Acmex2564/Z31-HVAC/README.md

# Z31-HVAC

This sure is a thing

36 pin board connector is TE 172023-1 Dual-Line Interlock (DLI). Same connector as on ECU. Same connector series as TCU, ASCD, Suspension Controller, DD Power Supply. 

5 pin board connector is TE 172040-1 - Multi Interlock Connector (MIC) Mk II.
