Acmex2564/Z31-HVAC/(threads)

Thread 1 (2022-05-30):

Wrong voltage divider values for discrete signals

Acmex2564, 2022-05-30:
150k/35.7k voltage divider inadequate to get logical high value from battery voltage (12V-12.7V). Reduce top of divider to ~100k (80k achieves reliable operation down to 8.7V)

Thread 2 (2022-05-30):

Silkscreen pinout on bottom of board

Acmex2564, 2022-05-30:
Currently half of the pin names are obscured by the connector when installed. All values should be replicated on the opposite board face.
