Acmex2564/Z31-HVAC/Design/Z31_HVAC_Disp_Rev2/Z31_HVAC_Disp_Rev2.kicad_pcb

## KiCad design Design/Z31_HVAC_Disp_Rev2/Z31_HVAC_Disp_Rev2.kicad_pcb (2022-09-29)

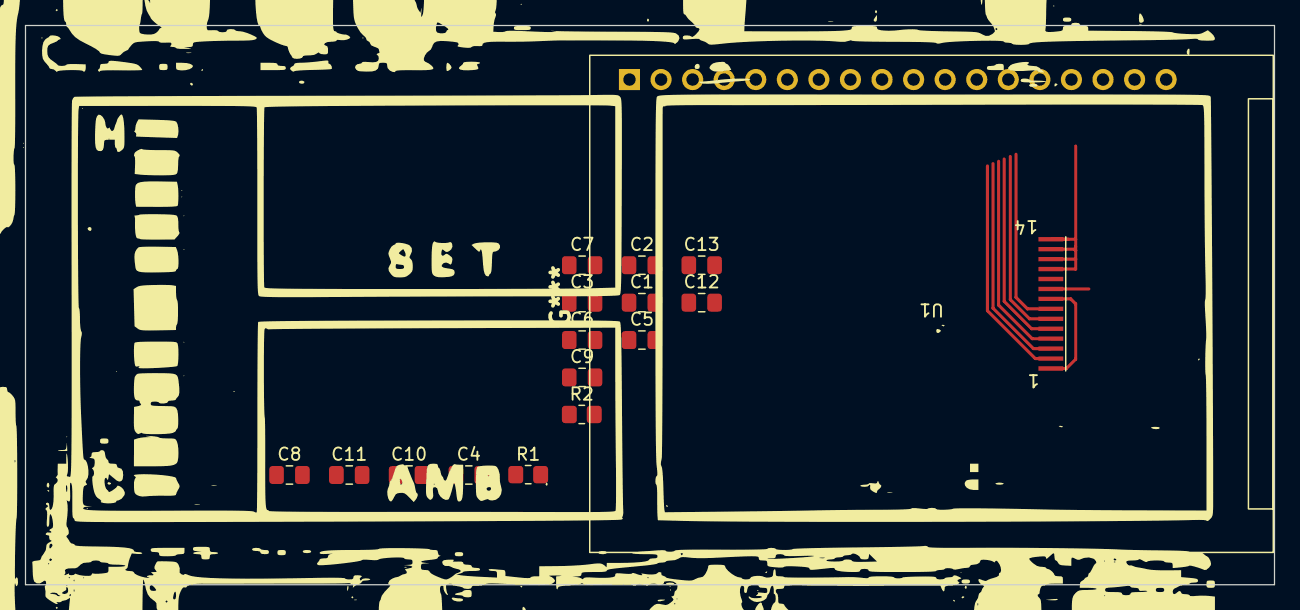
[picture p1: board Z31_HVAC_Disp_Rev2.kicad_pcb from above]

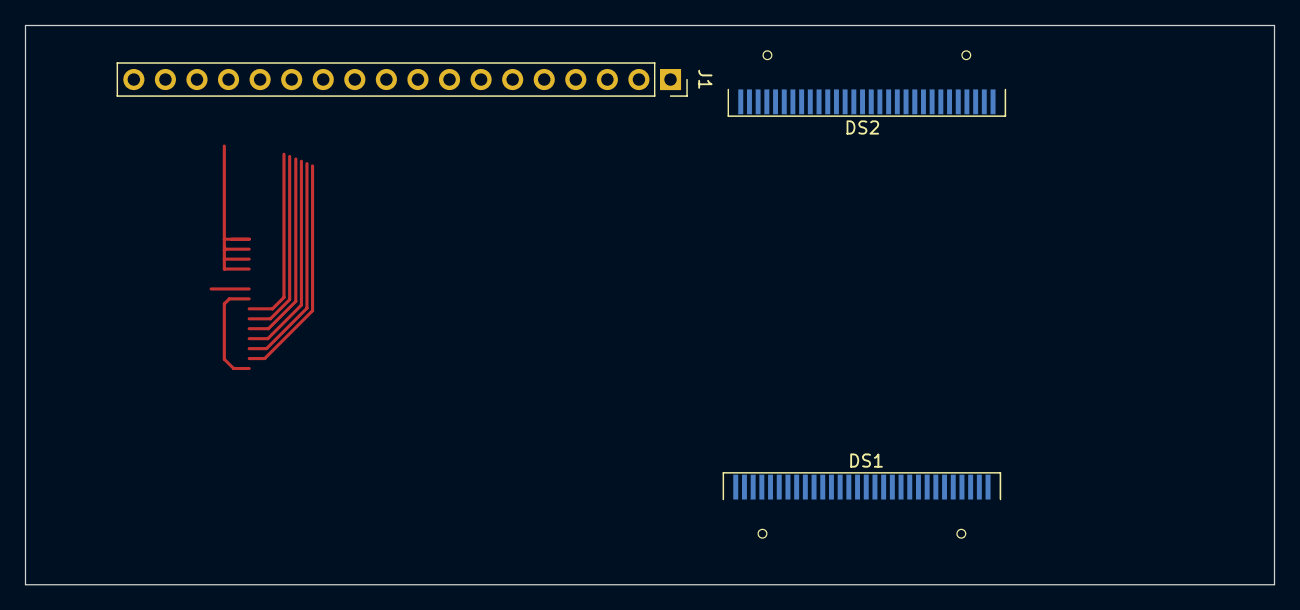
[picture p2: board Z31_HVAC_Disp_Rev2.kicad_pcb from below]

Board: 2 copper layers, 100.5 x 45.0 mm, 19 parts (3 on the bottom side), 26 nets.

Parts:
C1, C2, C5, C6, C8, C9, C11, C12: 1u; C_0805_2012Metric_Pad1.18x1.45mm_HandSolder
C3, C10: 4.7u; C_0805_2012Metric_Pad1.18x1.45mm_HandSolder
C4: 100n; C_0805_2012Metric_Pad1.18x1.45mm_HandSolder
C7, C13: 2.2u; C_0805_2012Metric_Pad1.18x1.45mm_HandSolder
DS1, DS2: OLED-128O064D
J1: Conn_01x18; PinSocket_1x18_P2.54mm_Vertical
R1, R2: 390k; R_0805_2012Metric_Pad1.20x1.40mm_HandSolder
U1: 2.2__WVGA_SPI_14pin; 2.2_wvga_spi

Connections:
+3V3: C4.1, C5.1, C6.1, C11.1, C12.1, DS1.6 (VBAT), DS1.9 (VDD), DS2.6 (VBAT), DS2.9 (VDD), J1.2, U1.9 (VCC)
/CS1: DS1.13 (~CS), J1.10
/CS2: DS2.13 (~CS), J1.9
/CS3: J1.8, U1.5 (CS)
/D/C: DS1.15 (D/~C), DS2.15 (D/~C), J1.6, U1.4 (D/CX)
/RESET1: DS1.14 (~RES), J1.13
/RESET2: DS2.14 (~RES), J1.12
/RESET3: J1.11, U1.2 (RESET)
/SCK: DS1.18 (D0), DS2.18 (D0), J1.3, U1.3 (SCL)
/SDI: DS1.19 (D1), DS2.19 (D1), J1.4, U1.6 (SDI)
/SDO: J1.5, U1.7 (SDO)
GND: C3.2, C4.2, C5.2, C6.2, C7.2, C10.2, C11.2, C12.2, C13.2, DS1.1 (GND), DS1.8 (VSS), DS1.10 (BS0), DS1.11 (BS1), DS1.12 (BS2), DS1.16 (R/~W), DS1.17 (E/~RD), DS1.21 (D3), DS1.22 (D4), DS1.23 (D5), DS1.24 (D6), DS1.25 (D7), DS1.29 (VLSS), DS1.30 (GND), DS2.1 (GND), DS2.8 (VSS), DS2.10 (BS0), DS2.11 (BS1), DS2.12 (BS2), DS2.16 (R/~W), DS2.17 (E/~RD), DS2.21 (D3), DS2.22 (D4), DS2.23 (D5), DS2.24 (D6), DS2.25 (D7), DS2.29 (VLSS), DS2.30 (GND), J1.1, J1.18, R1.2, R2.2, U1.1 (GND_P), U1.8 (GND), U1.11 (LEDK1), U1.12 (LEDK2), U1.13 (LEDK3), U1.14 (LEDK4)
unnamed: C1.1, DS1.2 (C2N)
unnamed: C1.2, DS1.3 (C2P)
unnamed: C2.1, DS1.4 (C1P)
unnamed: C2.2, DS1.5 (C1N)
unnamed: C3.1, DS1.27 (VCOMH)
unnamed: C7.1, DS1.28 (VCC)
unnamed: C8.1, DS2.2 (C2N)
unnamed: C8.2, DS2.3 (C2P)
unnamed: C9.1, DS2.4 (C1P)
unnamed: C9.2, DS2.5 (C1N)
unnamed: C10.1, DS2.27 (VCOMH)
unnamed: C13.1, DS2.28 (VCC)
unnamed: DS1.26 (IREF), R1.1
unnamed: DS2.26 (IREF), R2.1
