Acmex2564/Z31-HVAC/Design/Z31_HVAC_Disp_Rev1/Z31_HVAC_Disp_Rev1.kicad_pcb

## KiCad design Design/Z31_HVAC_Disp_Rev1/Z31_HVAC_Disp_Rev1.kicad_pcb (2022-04-08, an earlier design)

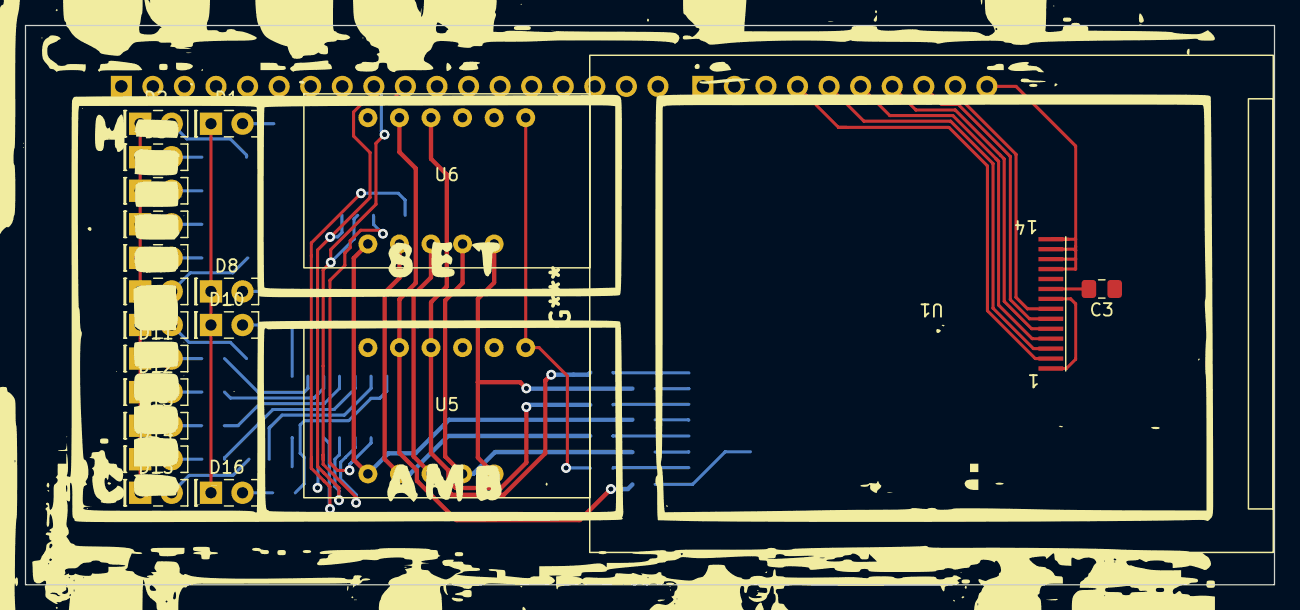
[picture p3: board Z31_HVAC_Disp_Rev1.kicad_pcb from above]

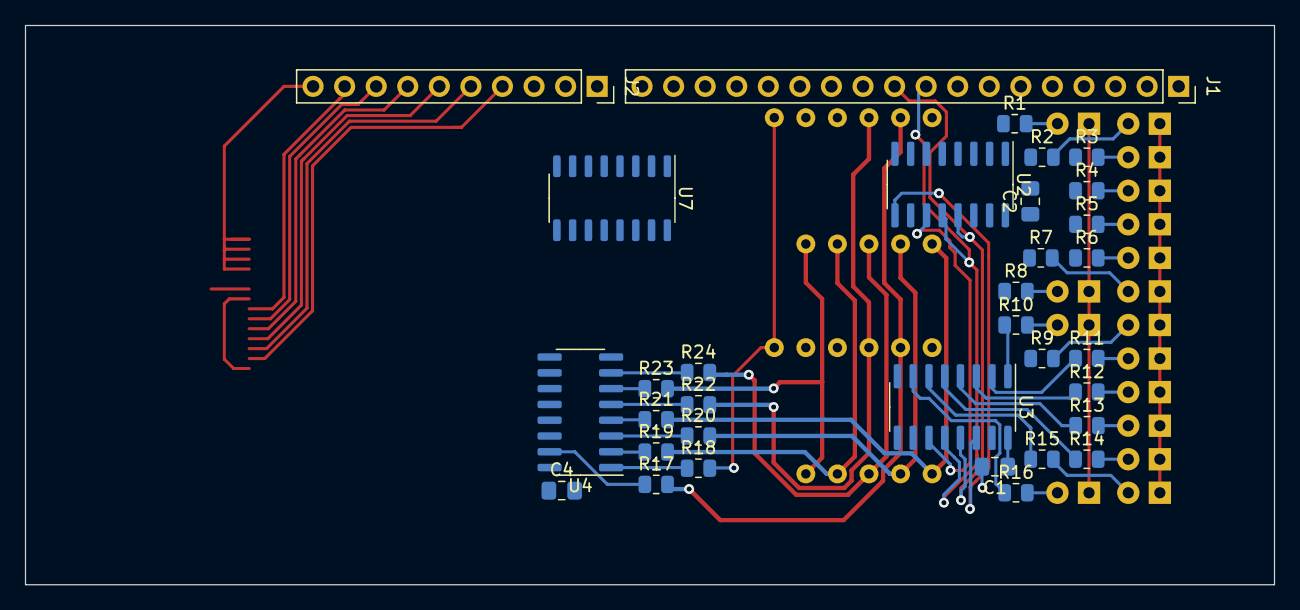
[picture p4: board Z31_HVAC_Disp_Rev1.kicad_pcb from below]

Board: 2 copper layers, 100.5 x 45.0 mm, 53 parts (33 on the bottom side), 79 nets.

Parts:
C1, C2, C3, C4: 100n; C_0805_2012Metric_Pad1.18x1.45mm_HandSolder
D1, D2, D3, D4, D5, D6, D7, D8, D9, D10, D11, D12, D13, D14, D15, D16: LED; LED_Rectangular_W5.0mm_H2.0mm
J1: Conn_01x18; PinSocket_1x18_P2.54mm_Vertical
J2: Conn_01x10; PinSocket_1x10_P2.54mm_Vertical
R1, R2, R3, R4, R5, R6, R7, R8, R9, R10, R11, R12, R13, R14, R15, R16, R17, R18, R19, R20, R21, R22, R23, R24: 220; R_0805_2012Metric
U1: 2.2__WVGA_SPI_14pin; 2.2_wvga_spi
U2, U3, U4: 74HC595; SOIC-16_3.9x9.9mm_P1.27mm
U5, U6: CL3631AH
U7: ULN2003; SO-16_3.9x9.9mm_P1.27mm

Connections:
+5V: C1.1, C2.1, C4.1, J1.2, U2.16 (VCC), U3.16 (VCC), U4.16 (VCC)
/Clear: J1.5, U2.10 (~SRCLR), U3.10 (~SRCLR), U4.10 (~SRCLR)
/D1: J1.11, U7.1 (I1)
/D2: J1.12, U7.2 (I2)
/D3: J1.13, U7.3 (I3)
/D4: J1.14, U7.4 (I4)
/D5: J1.15, U7.5 (I5)
/D6: J1.16, U7.6 (I6)
/LED_Dimming: J1.10, U2.13 (~OE), U3.13 (~OE), U4.13 (~OE)
/LH_1: J1.9, U2.12 (RCLK), U3.12 (RCLK)
/LH_2: J1.6, U4.12 (RCLK)
/MOSI_1: J1.7, U2.14 (SER)
/MOSI_2: J1.3, U4.14 (SER)
/SCK_1: J1.8, U2.11 (SRCLK), U3.11 (SRCLK)
/SCK_2: J1.4, U4.11 (SRCLK)
GND: C1.2, C2.2, C3.1, C4.2, D1.1 (K), D2.1 (K), D3.1 (K), D4.1 (K), D5.1 (K), D6.1 (K), D7.1 (K), D8.1 (K), D9.1 (K), D10.1 (K), D11.1 (K), D12.1 (K), D13.1 (K), D14.1 (K), D15.1 (K), D16.1 (K), J1.1, J1.18, J2.1, J2.10, U1.1 (GND_P), U1.8 (GND), U1.11 (LEDK1), U1.12 (LEDK2), U1.13 (LEDK3), U1.14 (LEDK4), U2.8 (GND), U3.8 (GND), U4.8 (GND), U7.8 (GND)
unnamed: C3.2, J2.2, U1.9 (VCC)
unnamed: D1.2 (A), R1.2
unnamed: D2.2 (A), R2.2
unnamed: D3.2 (A), R3.2
unnamed: D4.2 (A), R4.2
unnamed: D5.2 (A), R5.2
unnamed: D6.2 (A), R6.2
unnamed: D7.2 (A), R7.2
unnamed: D8.2 (A), R8.2
unnamed: D9.2 (A), R9.2
unnamed: D10.2 (A), R10.2
unnamed: D11.2 (A), R11.2
unnamed: D12.2 (A), R12.2
unnamed: D13.2 (A), R13.2
unnamed: D14.2 (A), R14.2
unnamed: D15.2 (A), R15.2
unnamed: D16.2 (A), R16.2
unnamed: J2.3, U1.10 (LEDA)
unnamed: J2.4, U1.2 (RESET)
unnamed: J2.5, U1.3 (SCL)
unnamed: J2.6, U1.4 (D/CX)
unnamed: J2.7, U1.5 (CS)
unnamed: J2.8, U1.6 (SDI)
unnamed: J2.9, U1.7 (SDO)
unnamed: R1.1, U2.15 (QA)
unnamed: R2.1, U2.1 (QB)
unnamed: R3.1, U2.2 (QC)
unnamed: R4.1, U2.3 (QD)
unnamed: R5.1, U2.4 (QE)
unnamed: R6.1, U2.5 (QF)
unnamed: R7.1, U2.6 (QG)
unnamed: R8.1, U2.7 (QH)
unnamed: R9.1, U3.15 (QA)
unnamed: R10.1, U3.1 (QB)
unnamed: R11.1, U3.2 (QC)
unnamed: R12.1, U3.3 (QD)
unnamed: R13.1, U3.4 (QE)
unnamed: R14.1, U3.5 (QF)
unnamed: R15.1, U3.6 (QG)
unnamed: R16.1, U3.7 (QH)
unnamed: R17.1, U4.15 (QA)
unnamed: R17.2, U5.11 (ANODE_A), U6.11 (ANODE_A)
unnamed: R18.1, U4.1 (QB)
unnamed: R18.2, U5.7 (ANODE_B), U6.7 (ANODE_B)
unnamed: R19.1, U4.2 (QC)
unnamed: R19.2, U5.4 (ANODE_C), U6.4 (ANODE_C)
unnamed: R20.1, U4.3 (QD)
unnamed: R20.2, U5.2 (ANODE_D), U6.2 (ANODE_D)
unnamed: R21.1, U4.4 (QE)
unnamed: R21.2, U5.1 (ANODE_E), U6.1 (ANODE_E)
unnamed: R22.1, U4.5 (QF)
unnamed: R22.2, U5.10 (ANODE_F), U6.10 (ANODE_F)
unnamed: R23.1, U4.6 (QG)
unnamed: R23.2, U5.5 (ANODE_G), U6.5 (ANODE_G)
unnamed: R24.1, U4.7 (QH)
unnamed: R24.2, U5.3 (ANODE_DP), U6.3 (ANODE_DP)
unnamed: U2.9 (QH'), U3.14 (SER)
unnamed: U5.8 (CATHODE_3), U7.16 (O1)
unnamed: U5.9 (CATHODE_2), U7.15 (O2)
unnamed: U5.12 (CATHODE_1), U7.14 (O3)
unnamed: U6.8 (CATHODE_3), U7.13 (O4)
unnamed: U6.9 (CATHODE_2), U7.12 (O5)
unnamed: U6.12 (CATHODE_1), U7.11 (O6)
