Acmex2564/Z31-HVAC/Design/Z31_HVAC_Main_Rev1/Z31_HVAC_Main_Rev1.kicad_pcb

## KiCad design Design/Z31_HVAC_Main_Rev1/Z31_HVAC_Main_Rev1.kicad_pcb (2022-04-08)

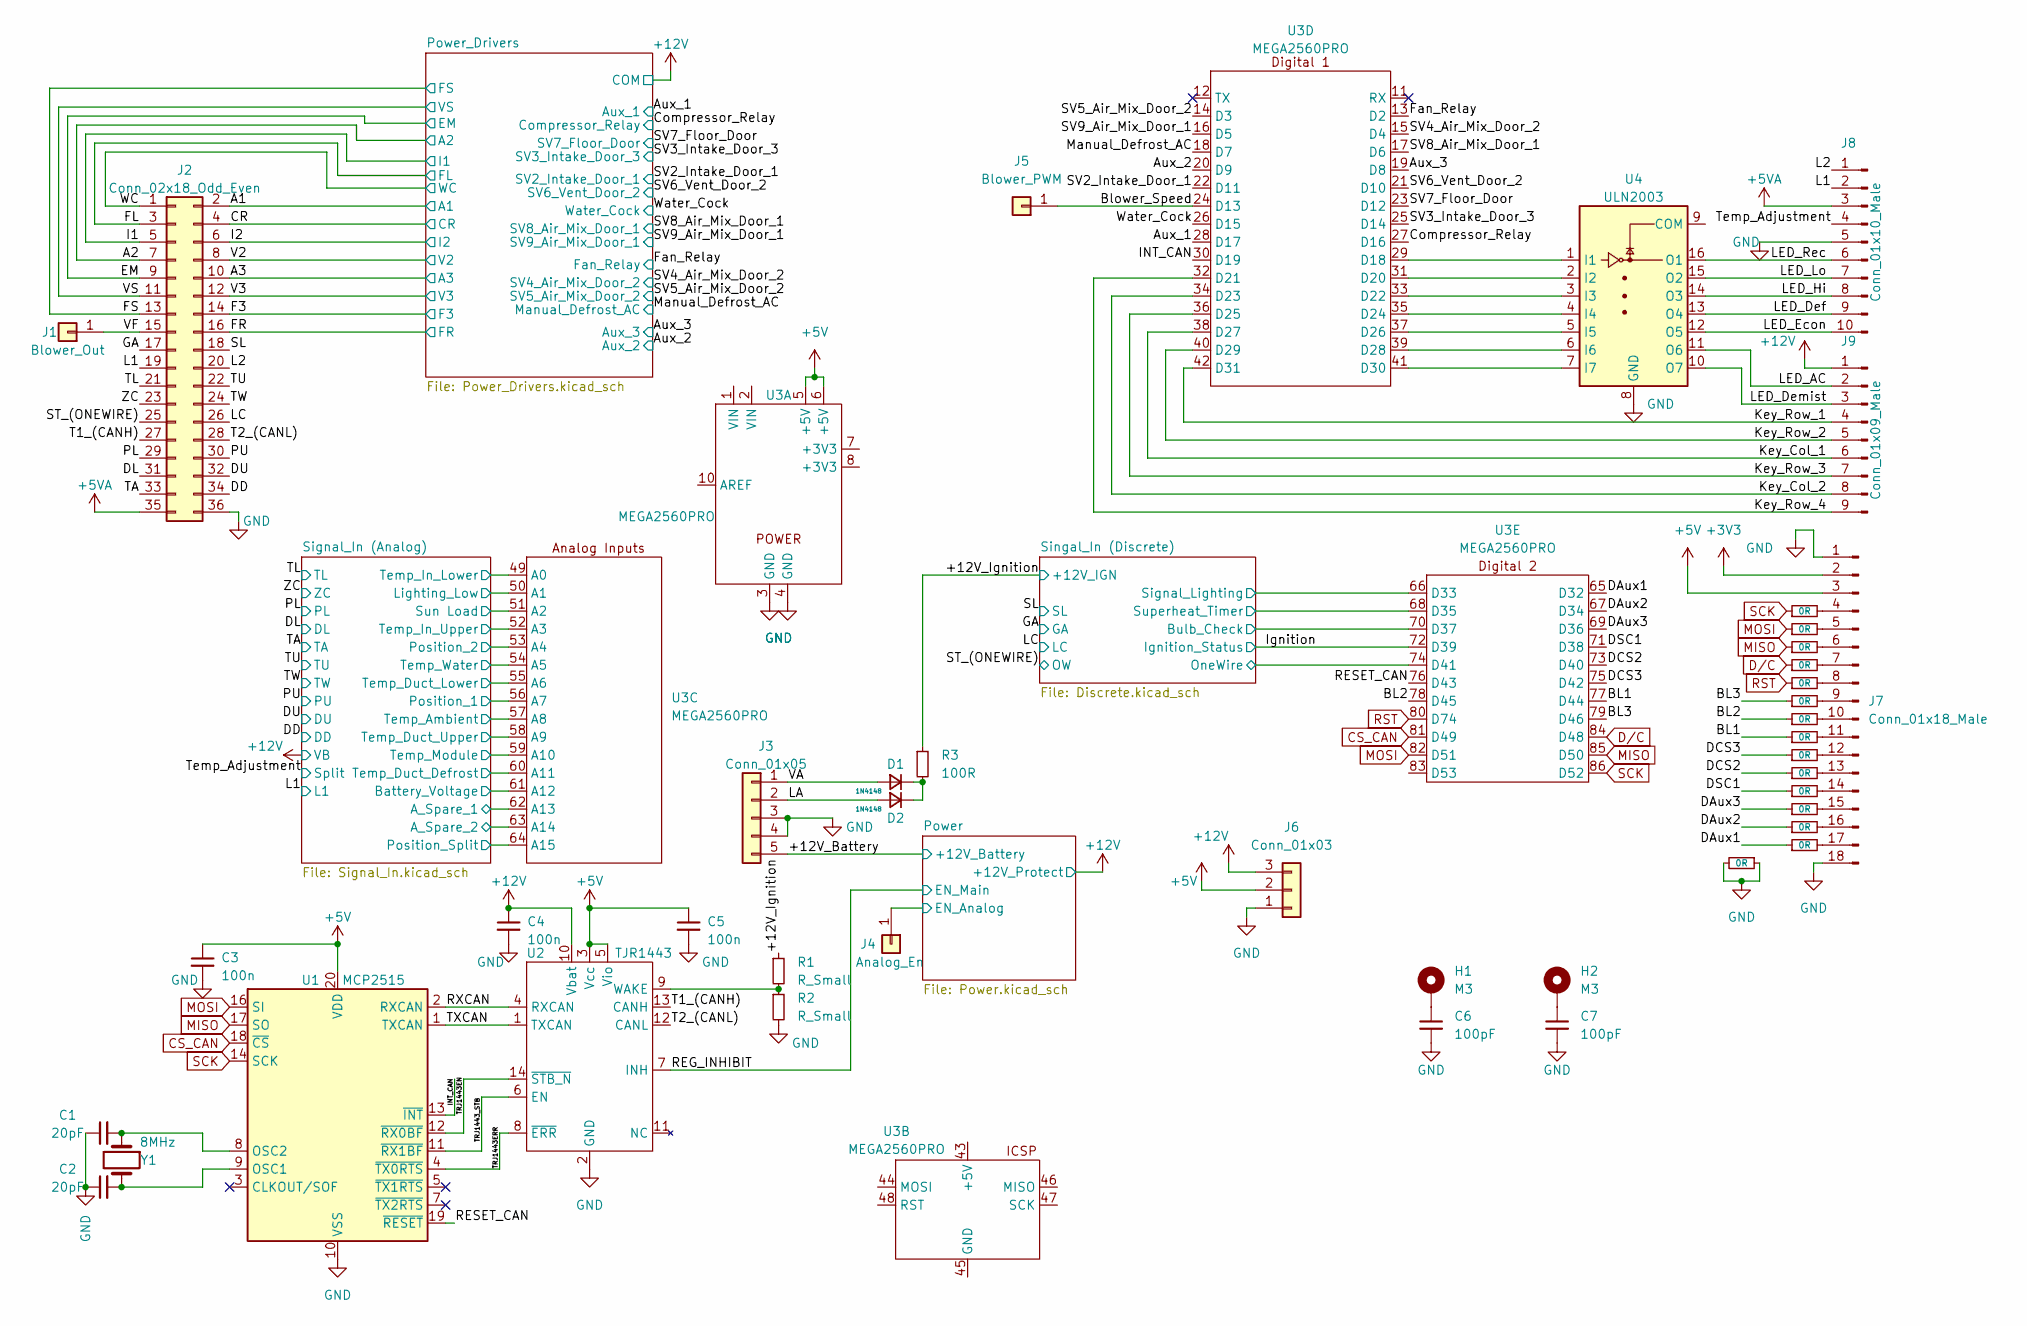
[picture p5: schematic Z31_HVAC_Main_Rev1.kicad_sch]

Parts:
C1, C2: 20pF; C_0805_2012Metric_Pad1.18x1.45mm_HandSolder
C3, C4, C5: 100n; C_0805_2012Metric_Pad1.18x1.45mm_HandSolder
C6, C7: 100pF; C_0805_2012Metric_Pad1.18x1.45mm_HandSolder
D1, D2: 1N4148; D_SOD-323_HandSoldering
H1, H2: M3; MountingHole_3.5mm_Pad
J1: Blower_Out; PinHeader_1x01_P2.54mm_Vertical
J2: Conn_02x18_Odd_Even; TE-172023
J3: Conn_01x05; Z31_HVAC_Connector_1
J4: Analog_En; PinHeader_1x01_P2.54mm_Vertical
J5: Blower_PWM; PinHeader_1x01_P2.54mm_Vertical
J6: Conn_01x03; Proto-Area
J7: Conn_01x18_Male; PinHeader_1x18_P2.54mm_Vertical
J8: Conn_01x10_Male; PinHeader_1x10_P2.54mm_Vertical
J9: Conn_01x09_Male; PinHeader_1x09_P2.54mm_Vertical
R1, R2: R_Small; R_0805_2012Metric_Pad1.20x1.40mm_HandSolder
R3: 100R; R_Axial_DIN0207_L6.3mm_D2.5mm_P7.62mm_Horizontal
R4, R5, R6, R7, R8, R9, R10, R11, R12, R13, R14, R15, R16, R17, R18: 0R; R_Axial_DIN0204_L3.6mm_D1.6mm_P2.54mm_Vertical
U1: MCP2515; TSSOP-20_4.4x6.5mm_P0.65mm
U2: TJR1443; SO-14_3.9x8.65mm_P1.27mm
U3: MEGA2560PRO
U4: ULN2003; SO-16_3.9x9.9mm_P1.27mm
Y1: 8MHz; Crystal_SMD_HC49-SD

Connections:
+3V3: J7.2
+5V: C3.1, C5.1, J6.2, J7.3, U1.20 (VDD), U2.3 (Vcc), U2.5 (Vio), U3.5 (+5V), U3.6 (+5V); also elsewhere on the board
+5VA: J2.35, J8.3; also elsewhere on the board
+12V: C4.1, J6.3, J9.1, U2.10 (Vbat); also elsewhere on the board
/+12V_Battery: J3.5; also elsewhere on the board
/+12V_Ignition: R1.1, R3.1; also elsewhere on the board
/A1: J2.2; also elsewhere on the board
/A2: J2.7; also elsewhere on the board
/A3: J2.10; also elsewhere on the board
/Aux_1: U3.28 (D17); also elsewhere on the board
/Aux_2: U3.20 (D9); also elsewhere on the board
/Aux_3: U3.19 (D8); also elsewhere on the board
/BL1: R12.1, U3.77 (D44)
/BL2: R11.1, U3.78 (D45)
/BL3: R10.1, U3.79 (D46)
/Blower_Speed: J5.1, U3.24 (D13)
/CR: J2.4; also elsewhere on the board
/Compressor_Relay: U3.27 (D16); also elsewhere on the board
/DAux1: R18.1, U3.65 (D32)
/DAux2: R17.1, U3.67 (D34)
/DAux3: R16.1, U3.69 (D36)
/DCS2: R14.1, U3.73 (D40)
/DCS3: R13.1, U3.75 (D42)
/DD: J2.34; also elsewhere on the board
/DL: J2.31; also elsewhere on the board
/DSC1: R15.1, U3.71 (D38)
/DU: J2.32; also elsewhere on the board
/EM: J2.9; also elsewhere on the board
/F3: J2.14; also elsewhere on the board
/FL: J2.3; also elsewhere on the board
/FR: J2.16; also elsewhere on the board
/FS: J2.13; also elsewhere on the board
/Fan_Relay: U3.13 (D2); also elsewhere on the board
/GA: J2.17; also elsewhere on the board
/I1: J2.5; also elsewhere on the board
/I2: J2.6; also elsewhere on the board
/INT_CAN: U1.13 (~INT), U3.30 (D19)
/Ignition: U3.72 (D39); also elsewhere on the board
/Key_Col_1: J9.6, U3.38 (D27)
/Key_Col_2: J9.8, U3.34 (D23)
/Key_Row_1: J9.4, U3.42 (D31)
/Key_Row_2: J9.5, U3.40 (D29)
/Key_Row_3: J9.7, U3.36 (D25)
/Key_Row_4: J9.9, U3.32 (D21)
/L1: J2.19, J8.2; also elsewhere on the board
/L2: J2.20, J8.1
/LA: D2.2 (A), J3.2
/LC: J2.26; also elsewhere on the board
/LED_AC: J9.2, U4.11 (O6)
/LED_Def: J8.9, U4.13 (O4)
/LED_Demist: J9.3, U4.10 (O7)
/LED_Econ: J8.10, U4.12 (O5)
/LED_Hi: J8.8, U4.14 (O3)
/LED_Lo: J8.7, U4.15 (O2)
/LED_Rec: J8.6, U4.16 (O1)
/Manual_Defrost_AC: U3.18 (D7); also elsewhere on the board
/PL: J2.29; also elsewhere on the board
/PU: J2.30; also elsewhere on the board
/Power/EN_Analog: J4.1; also elsewhere on the board
/REG_INHIBIT: U2.7 (INH); also elsewhere on the board
/RESET_CAN: U1.19 (~RESET), U3.76 (D43)
/RXCAN: U1.2 (RXCAN), U2.4 (RXCAN)
/SL: J2.18; also elsewhere on the board
/ST_(ONEWIRE): J2.25; also elsewhere on the board
/SV2_Intake_Door_1: U3.22 (D11); also elsewhere on the board
/SV3_Intake_Door_3: U3.25 (D14); also elsewhere on the board
/SV4_Air_Mix_Door_2: U3.15 (D4); also elsewhere on the board
/SV5_Air_Mix_Door_2: U3.14 (D3); also elsewhere on the board
/SV6_Vent_Door_2: U3.21 (D10); also elsewhere on the board
/SV7_Floor_Door: U3.23 (D12); also elsewhere on the board
/SV8_Air_Mix_Door_1: U3.17 (D6); also elsewhere on the board
/SV9_Air_Mix_Door_1: U3.16 (D5); also elsewhere on the board
/Signal_In (Analog)/A_Spare_1: U3.62 (A13); also elsewhere on the board
/Signal_In (Analog)/A_Spare_2: U3.63 (A14); also elsewhere on the board
/Signal_In (Analog)/Battery_Voltage: U3.61 (A12); also elsewhere on the board
/Signal_In (Analog)/Lighting_Low: U3.50 (A1); also elsewhere on the board
/Signal_In (Analog)/Position_1: U3.56 (A7); also elsewhere on the board
/Signal_In (Analog)/Position_2: U3.53 (A4); also elsewhere on the board
/Signal_In (Analog)/Position_Split: U3.64 (A15); also elsewhere on the board
/Signal_In (Analog)/Sun Load: U3.51 (A2); also elsewhere on the board
/Signal_In (Analog)/Temp_Ambient: U3.57 (A8); also elsewhere on the board
/Signal_In (Analog)/Temp_Duct_Defrost: U3.60 (A11); also elsewhere on the board
/Signal_In (Analog)/Temp_Duct_Lower: U3.55 (A6); also elsewhere on the board
/Signal_In (Analog)/Temp_Duct_Upper: U3.58 (A9); also elsewhere on the board
/Signal_In (Analog)/Temp_In_Lower: U3.49 (A0); also elsewhere on the board
/Signal_In (Analog)/Temp_In_Upper: U3.52 (A3); also elsewhere on the board
/Signal_In (Analog)/Temp_Module: U3.59 (A10); also elsewhere on the board
/Signal_In (Analog)/Temp_Water: U3.54 (A5); also elsewhere on the board
/Singal_In (Discrete)/Bulb_Check: U3.70 (D37); also elsewhere on the board
/Singal_In (Discrete)/OneWire: U3.74 (D41); also elsewhere on the board
/Singal_In (Discrete)/Signal_Lighting: U3.66 (D33); also elsewhere on the board
/Singal_In (Discrete)/Superheat_Timer: U3.68 (D35); also elsewhere on the board
/T1_(CANH): J2.27, U2.13 (CANH)
/T2_(CANL): J2.28, U2.12 (CANL)
/TA: J2.33; also elsewhere on the board
/TL: J2.21; also elsewhere on the board
/TRJ1443EN: U1.12 (~RX0BF), U2.14 (~STB_N)
/TRJ1443ERR: U1.4 (~TX0RTS), U2.8 (~ERR)
/TRJ1443_STB: U1.11 (~RX1BF), U2.6 (EN)
/TU: J2.22; also elsewhere on the board
/TW: J2.24; also elsewhere on the board
/TXCAN: U1.1 (TXCAN), U2.1 (TXCAN)
/Temp_Adjustment: J8.4; also elsewhere on the board
/V2: J2.8; also elsewhere on the board
/V3: J2.12; also elsewhere on the board
/VA: D1.2 (A), J3.1
/VF: J1.1, J2.15
/VS: J2.11; also elsewhere on the board
/WC: J2.1; also elsewhere on the board
/Water_Cock: U3.26 (D15); also elsewhere on the board
/ZC: J2.23; also elsewhere on the board
CS_CAN: U1.18 (~CS), U3.81 (D49)
D/C: R8.1, U3.84 (D48)
GND: C1.1, C2.1, C3.2, C4.2, C5.2, C6.2, C7.2, J2.36, J3.3, J3.4, J6.1, J7.1, J7.18, J8.5, R2.2, R4.1, R4.2, U1.10 (VSS), U2.2 (GND), U3.3 (GND), U3.4 (GND), U4.8 (GND); also elsewhere on the board
MISO: R7.1, U1.17 (SO), U3.85 (D50)
MOSI: R6.1, U1.16 (SI), U3.82 (D51)
unnamed: C1.2, U1.8 (OSC2), Y1.1
unnamed: C2.2, U1.9 (OSC1), Y1.2
unnamed: C6.1, H1.1
unnamed: C7.1, H2.1
unnamed: D1.1 (K), D2.1 (K), R3.2
unnamed: J7.4, R5.2
unnamed: J7.5, R6.2
unnamed: J7.6, R7.2
unnamed: J7.7, R8.2
unnamed: J7.8, R9.2
unnamed: J7.9, R10.2
unnamed: J7.10, R11.2
unnamed: J7.11, R12.2
unnamed: J7.12, R13.2
unnamed: J7.13, R14.2
unnamed: J7.14, R15.2
unnamed: J7.15, R16.2
unnamed: J7.16, R17.2
unnamed: J7.17, R18.2
unnamed: R1.2, R2.1, U2.9 (WAKE)
unnamed: U3.29 (D18), U4.1 (I1)
unnamed: U3.31 (D20), U4.2 (I2)
unnamed: U3.33 (D22), U4.3 (I3)
unnamed: U3.35 (D24), U4.4 (I4)
unnamed: U3.37 (D26), U4.5 (I5)
unnamed: U3.39 (D28), U4.6 (I6)
unnamed: U3.41 (D30), U4.7 (I7)
RST: R9.1, U3.80 (D74)
SCK: R5.1, U1.14 (SCK), U3.86 (D52)

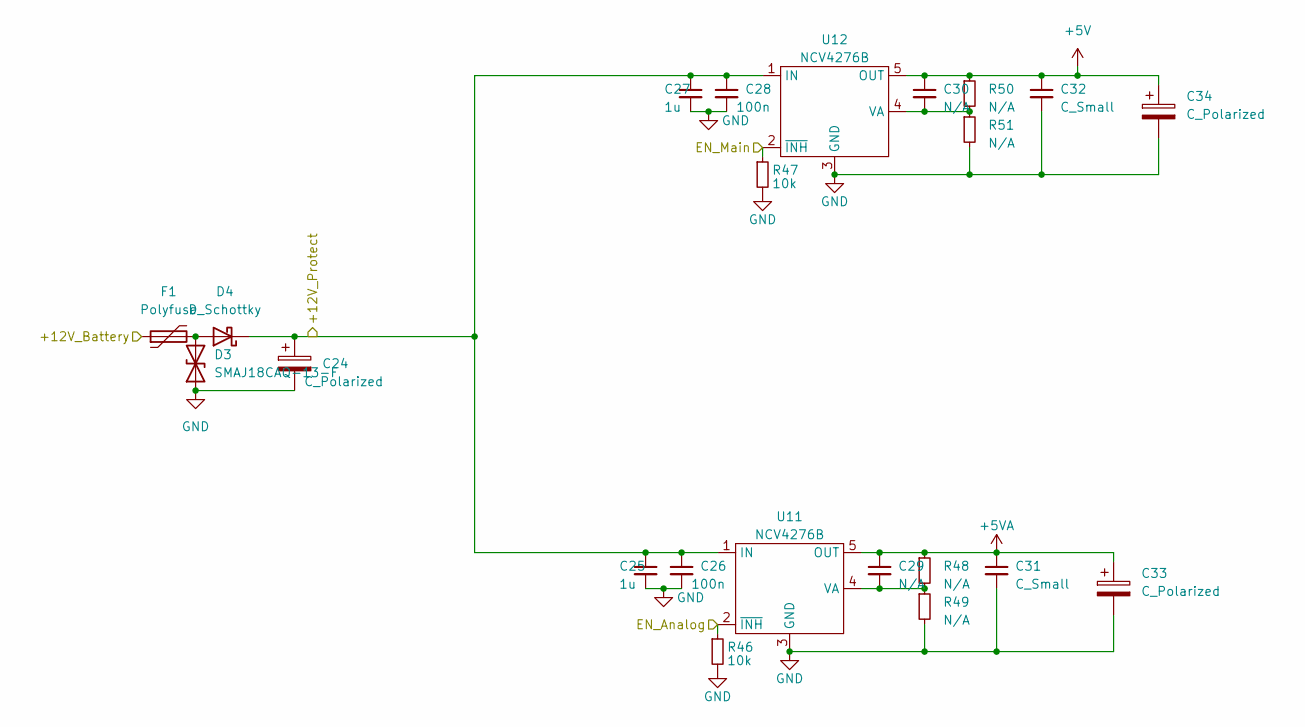
[picture p6: schematic Power.kicad_sch]

Parts:
C24: C_Polarized; CP_Radial_D8.0mm_P3.50mm
C25, C27: 1u; C_1210_3225Metric_Pad1.33x2.70mm_HandSolder
C26, C28: 100n; C_0805_2012Metric_Pad1.18x1.45mm_HandSolder
C29, C30: N/A; C_0805_2012Metric_Pad1.18x1.45mm_HandSolder
C31, C32: C_Small; C_1210_3225Metric_Pad1.33x2.70mm_HandSolder
C33, C34: C_Polarized; CP_Elec_5x5.3
D3: SMAJ18CAQ-13-F; D_SMA
D4: D_Schottky; D_SMA
F1: Polyfuse; Fuse_1812_4532Metric_Pad1.30x3.40mm_HandSolder
R46, R47: 10k; R_0805_2012Metric_Pad1.20x1.40mm_HandSolder
R48, R49, R50, R51: N/A; R_0805_2012Metric_Pad1.20x1.40mm_HandSolder
U11, U12: NCV4276B; TO-263-5_TabPin3

Connections:
+5V: C30.1, C32.1, C34.1, R50.1, U12.5 (OUT); also elsewhere on the board
+5VA: C29.1, C31.1, C33.1, R48.1, U11.5 (OUT); also elsewhere on the board
+12V: C24.1, C25.1, C26.1, C27.1, C28.1, D4.1 (K), U11.1 (IN), U12.1 (IN); also elsewhere on the board
/+12V_Battery: F1.1; also elsewhere on the board
/Power/EN_Analog: R46.1, U11.2 (~INH); also elsewhere on the board
/REG_INHIBIT: R47.1, U12.2 (~INH); also elsewhere on the board
GND: C24.2, C25.2, C26.2, C27.2, C28.2, C31.2, C32.2, C33.2, C34.2, D3.1 (A1), R46.2, R47.2, R49.2, R51.2, U11.3 (GND), U12.3 (GND); also elsewhere on the board
unnamed: C29.2, R48.2, R49.1, U11.4 (VA)
unnamed: C30.2, R50.2, R51.1, U12.4 (VA)
unnamed: D3.2 (A2), D4.2 (A), F1.2

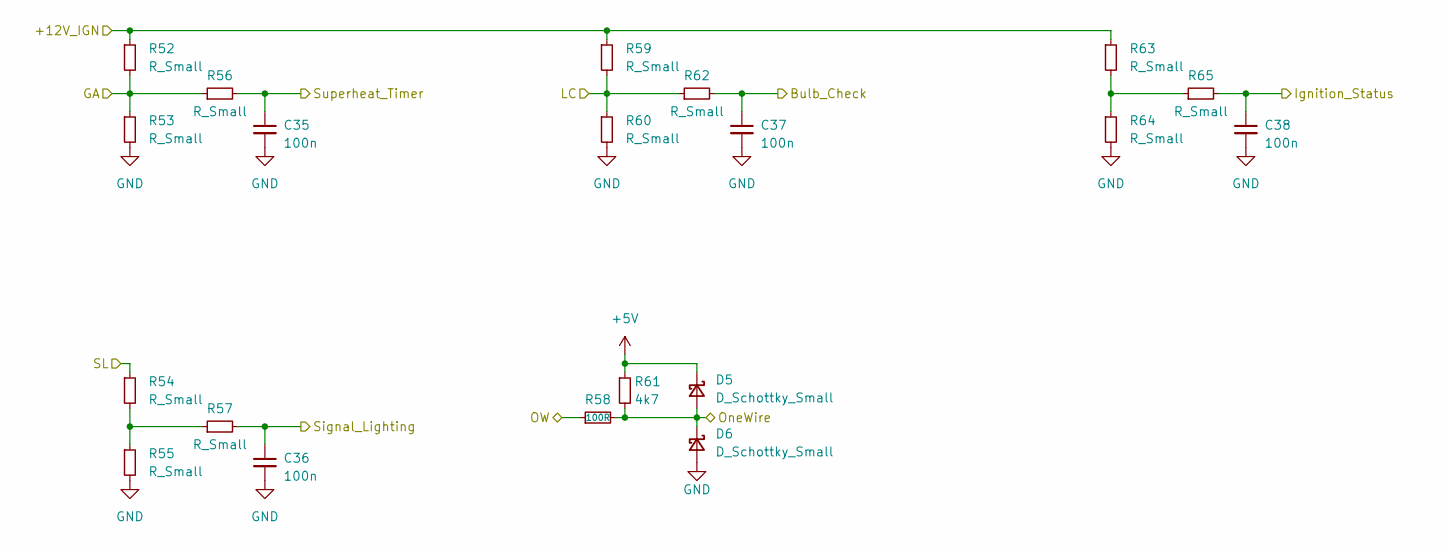
[picture p7: schematic Discrete.kicad_sch]

Parts:
C35, C36, C37, C38: 100n; C_0805_2012Metric_Pad1.18x1.45mm_HandSolder
D5, D6: D_Schottky_Small; D_SOD-323_HandSoldering
R52, R53, R54, R55, R56, R57, R59, R60, R62, R63, R64, R65: R_Small; R_0805_2012Metric_Pad1.20x1.40mm_HandSolder
R58: 100R; R_0805_2012Metric_Pad1.20x1.40mm_HandSolder
R61: 4k7; R_0805_2012Metric_Pad1.20x1.40mm_HandSolder

Connections:
+5V: D5.1 (K), R61.1; also elsewhere on the board
/+12V_Ignition: R52.1, R59.1, R63.1; also elsewhere on the board
/GA: R52.2, R53.1, R56.1; also elsewhere on the board
/Ignition: C38.1, R65.2; also elsewhere on the board
/LC: R59.2, R60.1, R62.1; also elsewhere on the board
/SL: R54.1; also elsewhere on the board
/ST_(ONEWIRE): R58.1; also elsewhere on the board
/Singal_In (Discrete)/Bulb_Check: C37.1, R62.2; also elsewhere on the board
/Singal_In (Discrete)/OneWire: D5.2 (A), D6.1 (K), R58.2, R61.2; also elsewhere on the board
/Singal_In (Discrete)/Signal_Lighting: C36.1, R57.2; also elsewhere on the board
/Singal_In (Discrete)/Superheat_Timer: C35.1, R56.2; also elsewhere on the board
GND: C35.2, C36.2, C37.2, C38.2, D6.2 (A), R53.2, R55.2, R60.2, R64.2; also elsewhere on the board
unnamed: R54.2, R55.1, R57.1
unnamed: R63.2, R64.1, R65.1

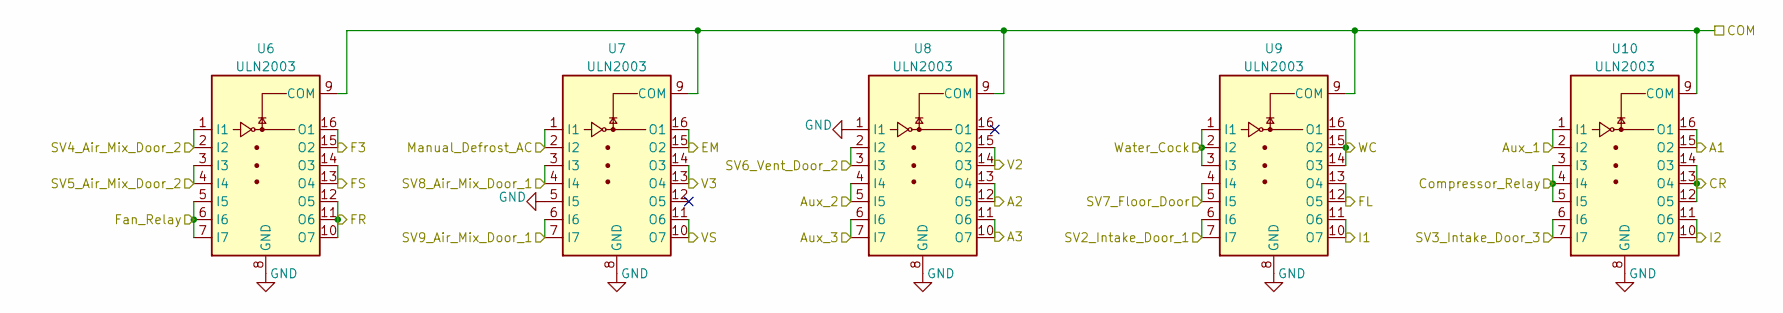
[picture p8: schematic Power_Drivers.kicad_sch]

Parts:
U6, U7, U8, U9, U10: ULN2003; SO-16_3.9x9.9mm_P1.27mm

Connections:
+12V: U6.9 (COM), U7.9 (COM), U8.9 (COM), U9.9 (COM), U10.9 (COM); also elsewhere on the board
/A1: U10.15 (O2), U10.16 (O1); also elsewhere on the board
/A2: U8.12 (O5), U8.13 (O4); also elsewhere on the board
/A3: U8.10 (O7), U8.11 (O6); also elsewhere on the board
/Aux_1: U10.1 (I1), U10.2 (I2); also elsewhere on the board
/Aux_2: U8.4 (I4), U8.5 (I5); also elsewhere on the board
/Aux_3: U8.6 (I6), U8.7 (I7); also elsewhere on the board
/CR: U10.12 (O5), U10.13 (O4), U10.14 (O3); also elsewhere on the board
/Compressor_Relay: U10.3 (I3), U10.4 (I4), U10.5 (I5); also elsewhere on the board
/EM: U7.15 (O2), U7.16 (O1); also elsewhere on the board
/F3: U6.15 (O2), U6.16 (O1); also elsewhere on the board
/FL: U9.12 (O5), U9.13 (O4); also elsewhere on the board
/FR: U6.10 (O7), U6.11 (O6), U6.12 (O5); also elsewhere on the board
/FS: U6.13 (O4), U6.14 (O3); also elsewhere on the board
/Fan_Relay: U6.5 (I5), U6.6 (I6), U6.7 (I7); also elsewhere on the board
/I1: U9.10 (O7), U9.11 (O6); also elsewhere on the board
/I2: U10.10 (O7), U10.11 (O6); also elsewhere on the board
/Manual_Defrost_AC: U7.1 (I1), U7.2 (I2); also elsewhere on the board
/SV2_Intake_Door_1: U9.6 (I6), U9.7 (I7); also elsewhere on the board
/SV3_Intake_Door_3: U10.6 (I6), U10.7 (I7); also elsewhere on the board
/SV4_Air_Mix_Door_2: U6.1 (I1), U6.2 (I2); also elsewhere on the board
/SV5_Air_Mix_Door_2: U6.3 (I3), U6.4 (I4); also elsewhere on the board
/SV6_Vent_Door_2: U8.2 (I2), U8.3 (I3); also elsewhere on the board
/SV7_Floor_Door: U9.4 (I4), U9.5 (I5); also elsewhere on the board
/SV8_Air_Mix_Door_1: U7.3 (I3), U7.4 (I4); also elsewhere on the board
/SV9_Air_Mix_Door_1: U7.6 (I6), U7.7 (I7); also elsewhere on the board
/V2: U8.14 (O3), U8.15 (O2); also elsewhere on the board
/V3: U7.13 (O4), U7.14 (O3); also elsewhere on the board
/VS: U7.10 (O7), U7.11 (O6); also elsewhere on the board
/WC: U9.14 (O3), U9.15 (O2), U9.16 (O1); also elsewhere on the board
/Water_Cock: U9.1 (I1), U9.2 (I2), U9.3 (I3); also elsewhere on the board
GND: U6.8 (GND), U7.5 (I5), U7.8 (GND), U8.1 (I1), U8.8 (GND), U9.8 (GND), U10.8 (GND); also elsewhere on the board
