Acmex2564/Z31-HVAC/Design/Z31_HVAC_Main_Rev1/Z31_HVAC_Main_Rev1.kicad_pcb

## KiCad design Design/Z31_HVAC_Main_Rev1/Z31_HVAC_Main_Rev1.kicad_pcb (continued)

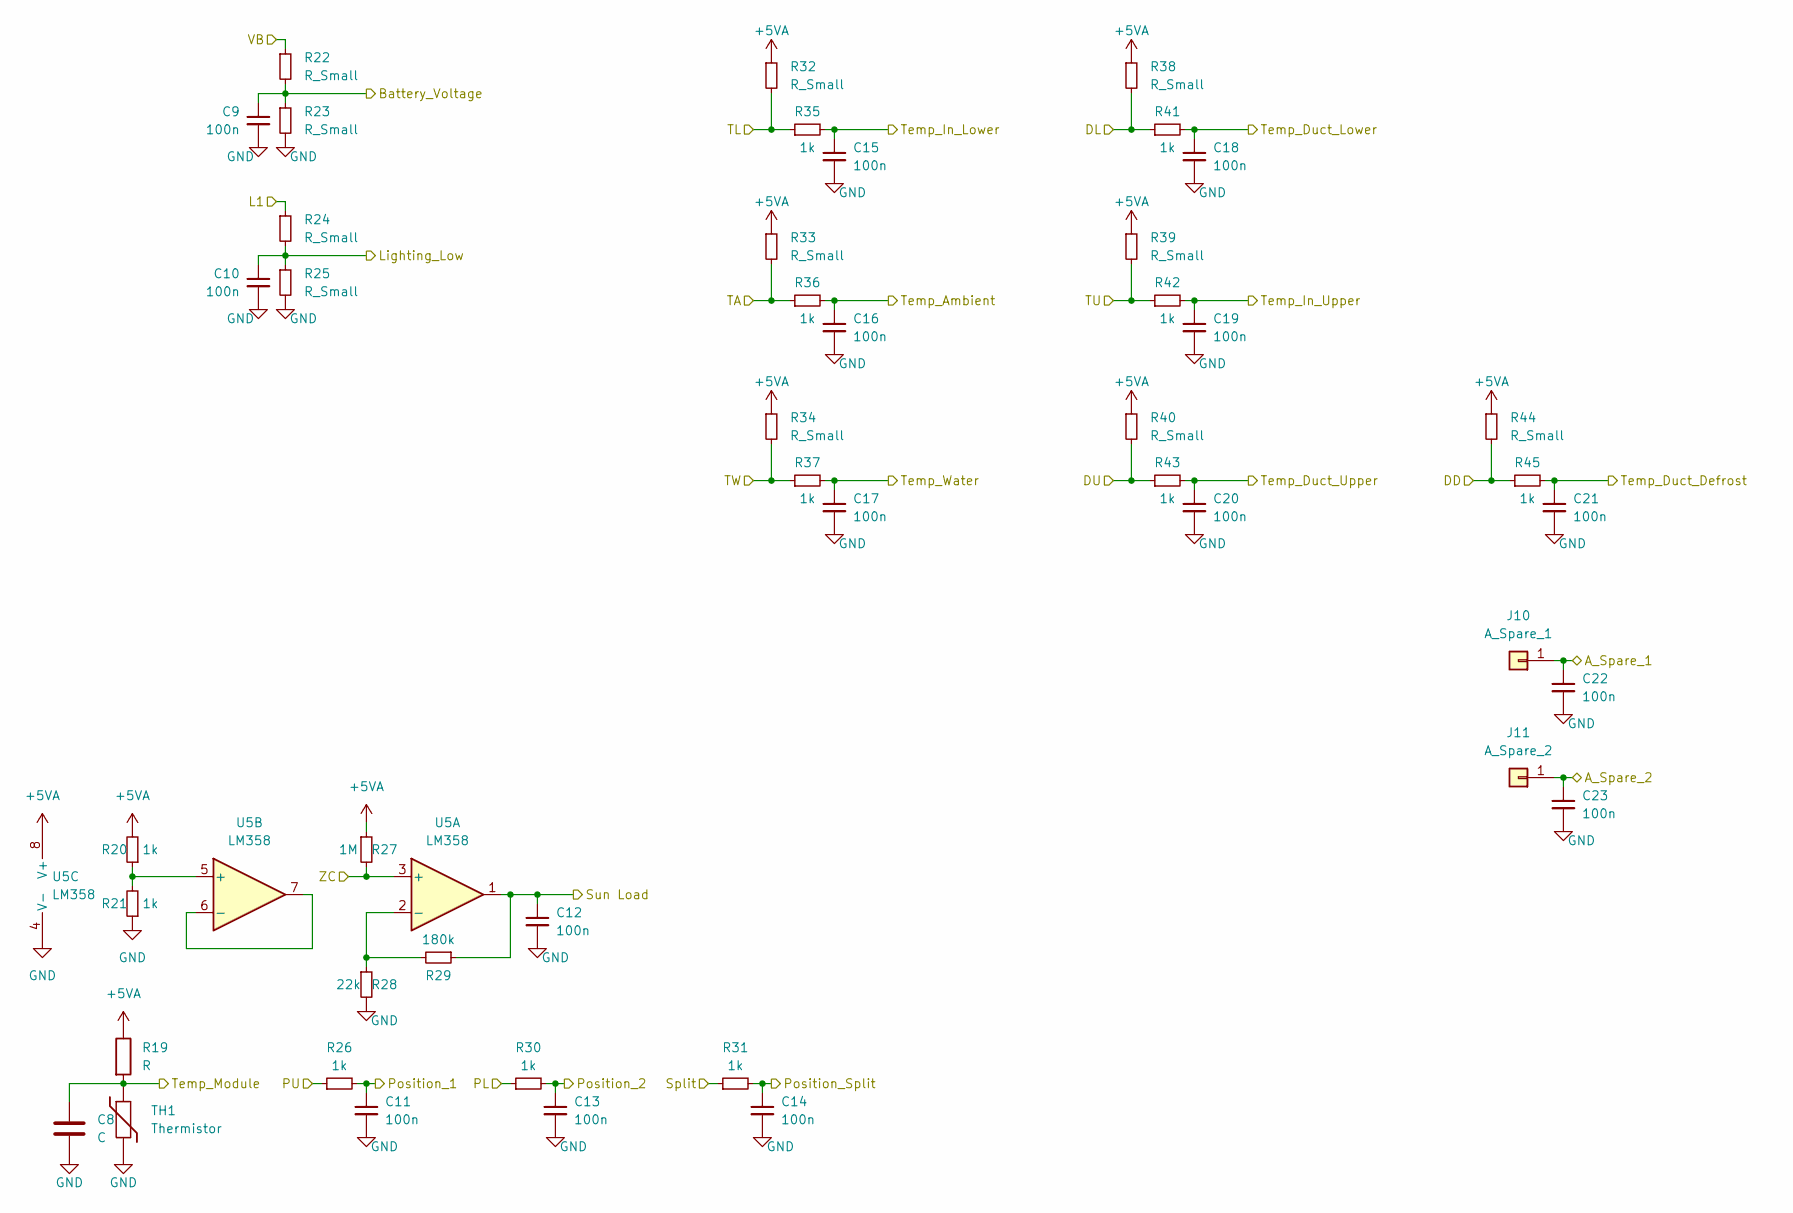
[picture p9: schematic Signal_In.kicad_sch]

Parts:
C8: C; C_0805_2012Metric_Pad1.18x1.45mm_HandSolder
C9, C10, C11, C12, C13, C14, C15, C16, C17, C18, C19, C20, C21, C22, C23: 100n; C_0805_2012Metric_Pad1.18x1.45mm_HandSolder
J10: A_Spare_1; PinHeader_1x01_P2.54mm_Vertical
J11: A_Spare_2; PinHeader_1x01_P2.54mm_Vertical
R19: R; R_0805_2012Metric_Pad1.20x1.40mm_HandSolder
R20, R21, R26, R30, R31, R35, R36, R37, R41, R42, R43, R45: 1k; R_0805_2012Metric_Pad1.20x1.40mm_HandSolder
R22, R23, R24, R25: R_Small; R_0805_2012Metric_Pad1.20x1.40mm_HandSolder
R27: 1M; R_Axial_DIN0207_L6.3mm_D2.5mm_P10.16mm_Horizontal
R28: 22k; R_0805_2012Metric_Pad1.20x1.40mm_HandSolder
R29: 180k; R_0805_2012Metric_Pad1.20x1.40mm_HandSolder
R32, R33, R34, R38, R39, R40, R44: R_Small; R_Axial_DIN0207_L6.3mm_D2.5mm_P10.16mm_Horizontal
TH1: Thermistor; R_0805_2012Metric_Pad1.20x1.40mm_HandSolder
U5: LM358; SO-8_5.3x6.2mm_P1.27mm

Connections:
+5VA: R19.1, R20.2, R27.1, R32.1, R33.1, R34.1, R38.1, R39.1, R40.1, R44.1, U5.8 (V+); also elsewhere on the board
+12V: R22.1; also elsewhere on the board
/DD: R44.2, R45.1; also elsewhere on the board
/DL: R38.2, R41.1; also elsewhere on the board
/DU: R40.2, R43.1; also elsewhere on the board
/L1: R24.1; also elsewhere on the board
/PL: R30.1; also elsewhere on the board
/PU: R26.1; also elsewhere on the board
/Signal_In (Analog)/A_Spare_1: C22.1, J10.1; also elsewhere on the board
/Signal_In (Analog)/A_Spare_2: C23.1, J11.1; also elsewhere on the board
/Signal_In (Analog)/Battery_Voltage: C9.1, R22.2, R23.1; also elsewhere on the board
/Signal_In (Analog)/Lighting_Low: C10.1, R24.2, R25.1; also elsewhere on the board
/Signal_In (Analog)/Position_1: C11.1, R26.2; also elsewhere on the board
/Signal_In (Analog)/Position_2: C13.1, R30.2; also elsewhere on the board
/Signal_In (Analog)/Position_Split: C14.1, R31.2; also elsewhere on the board
/Signal_In (Analog)/Sun Load: C12.1, R29.1, U5.1; also elsewhere on the board
/Signal_In (Analog)/Temp_Ambient: C16.1, R36.2; also elsewhere on the board
/Signal_In (Analog)/Temp_Duct_Defrost: C21.1, R45.2; also elsewhere on the board
/Signal_In (Analog)/Temp_Duct_Lower: C18.1, R41.2; also elsewhere on the board
/Signal_In (Analog)/Temp_Duct_Upper: C20.1, R43.2; also elsewhere on the board
/Signal_In (Analog)/Temp_In_Lower: C15.1, R35.2; also elsewhere on the board
/Signal_In (Analog)/Temp_In_Upper: C19.1, R42.2; also elsewhere on the board
/Signal_In (Analog)/Temp_Module: C8.1, R19.2, TH1.1; also elsewhere on the board
/Signal_In (Analog)/Temp_Water: C17.1, R37.2; also elsewhere on the board
/TA: R33.2, R36.1; also elsewhere on the board
/TL: R32.2, R35.1; also elsewhere on the board
/TU: R39.2, R42.1; also elsewhere on the board
/TW: R34.2, R37.1; also elsewhere on the board
/Temp_Adjustment: R31.1; also elsewhere on the board
/ZC: R27.2, U5.3 (+); also elsewhere on the board
GND: C8.2, C9.2, C10.2, C11.2, C12.2, C13.2, C14.2, C15.2, C16.2, C17.2, C18.2, C19.2, C20.2, C21.2, C22.2, C23.2, R21.1, R23.2, R25.2, R28.2, TH1.2, U5.4 (V-); also elsewhere on the board
unnamed: R20.1, R21.2, U5.5 (+)
unnamed: R28.1, R29.2, U5.2 (-)
unnamed: U5.6 (-), U5.7

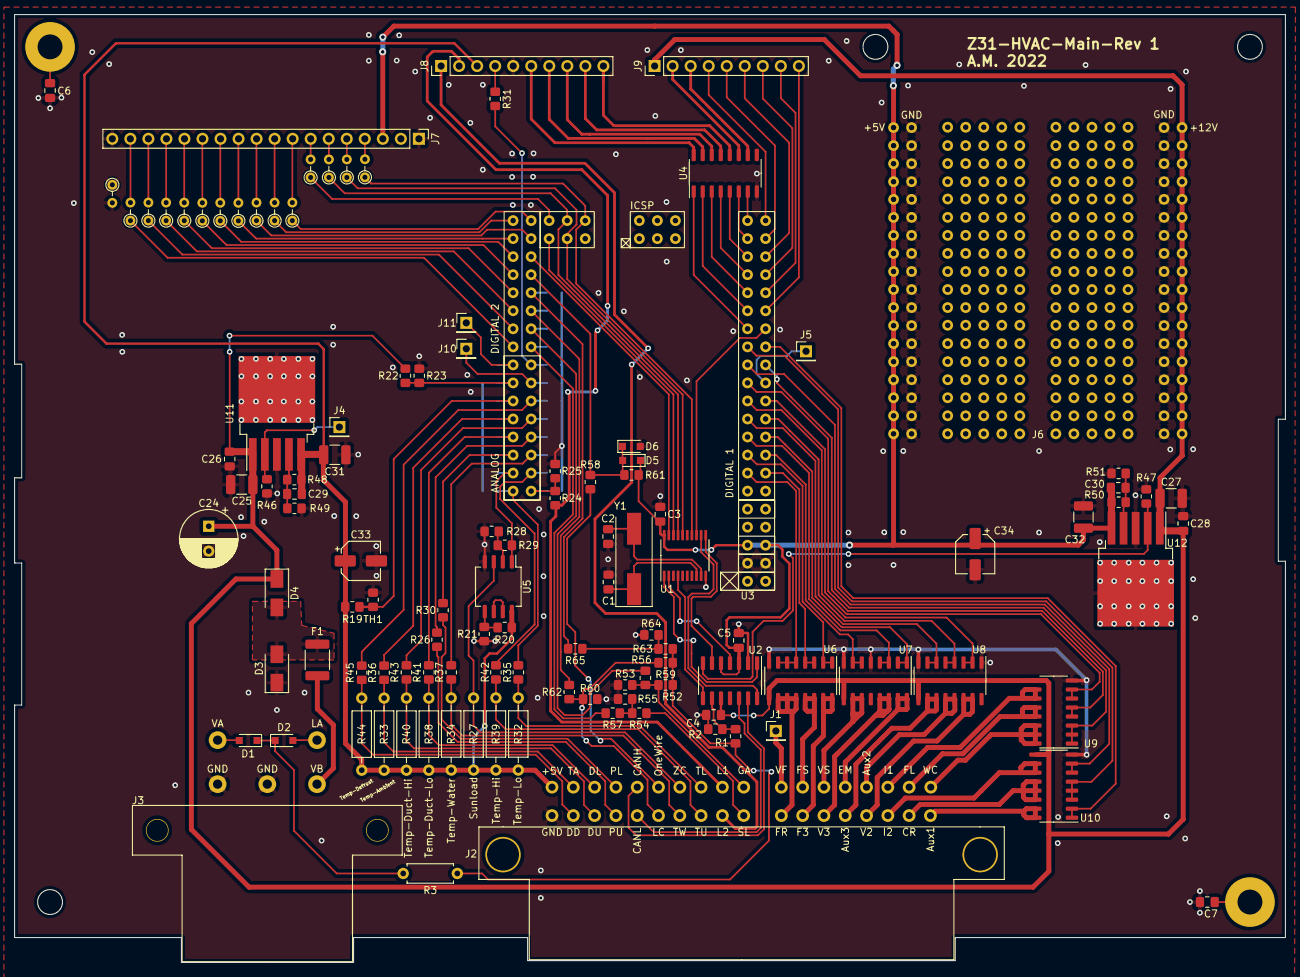
[picture p10: board Z31_HVAC_Main_Rev1.kicad_pcb from above]

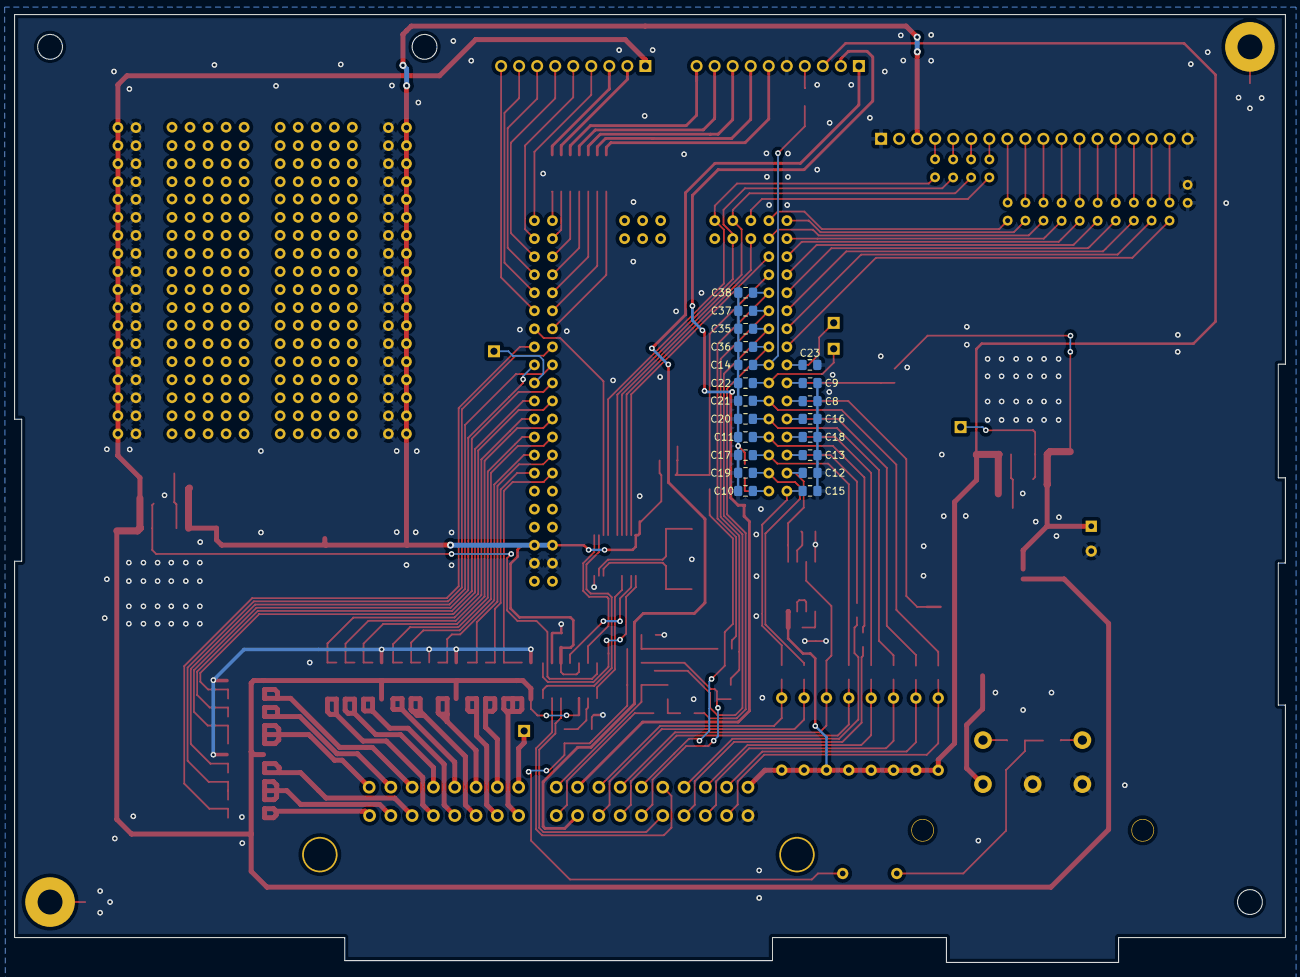
[picture p11: board Z31_HVAC_Main_Rev1.kicad_pcb from below]

Board: 2 copper layers, 179.0 x 133.5 mm, 137 parts (20 on the bottom side), 152 nets.
