Acmex2564/Z31-HVAC/(commit log)

2021-12-24 upgrade file versions
    [Z31_HVAC_Main_Rev1.kicad_pcb]
2021-12-26 update to kicad-6
    [Z31_HVAC_Main_Rev1.kicad_pcb, Z31_HVAC_Main_Rev1.kicad_sch]
2022-04-08 large changes
    [Power_Drivers.kicad_sch, Signal_In.kicad_sch, Z31_HVAC_Disp_Rev1.kicad_pcb, Z31_HVAC_Disp_Rev1.kicad_sch, Z31_HVAC_Main_Rev1.kicad_pcb, Z31_HVAC_Main_Rev1.kicad_sch]
2022-04-08 add sub sheets
    [Discrete.kicad_sch, Power.kicad_sch]
2022-09-29 Catchup Commit
    [Z31_HVAC_Disp_Rev2.kicad_pcb, Z31_HVAC_Disp_Rev2.kicad_sch]
2022-10-23 Include debug print statements in mixdoor adjustment
2022-10-23 Fix ' to " and strike errant ' in #includes
    [HVAC_Test_Stub_V2.ino, hvaclib.cpp]
2022-12-22 Add exponential curve for temperature sensors
2023-01-07 Fix endlessly cycling mix door positions (probably)
    [hvaclib.cpp]
2023-01-07 Increase mix door adjustment frequency Remove CAN temperature debug print
2023-01-08 Backup plan for leaking lower door actuator
    [hvaclib.cpp]
